madcatse/delta75-48kto128kupgrade/128k_expander_2/Delta_CA_addon_128K_v1.1.JPG

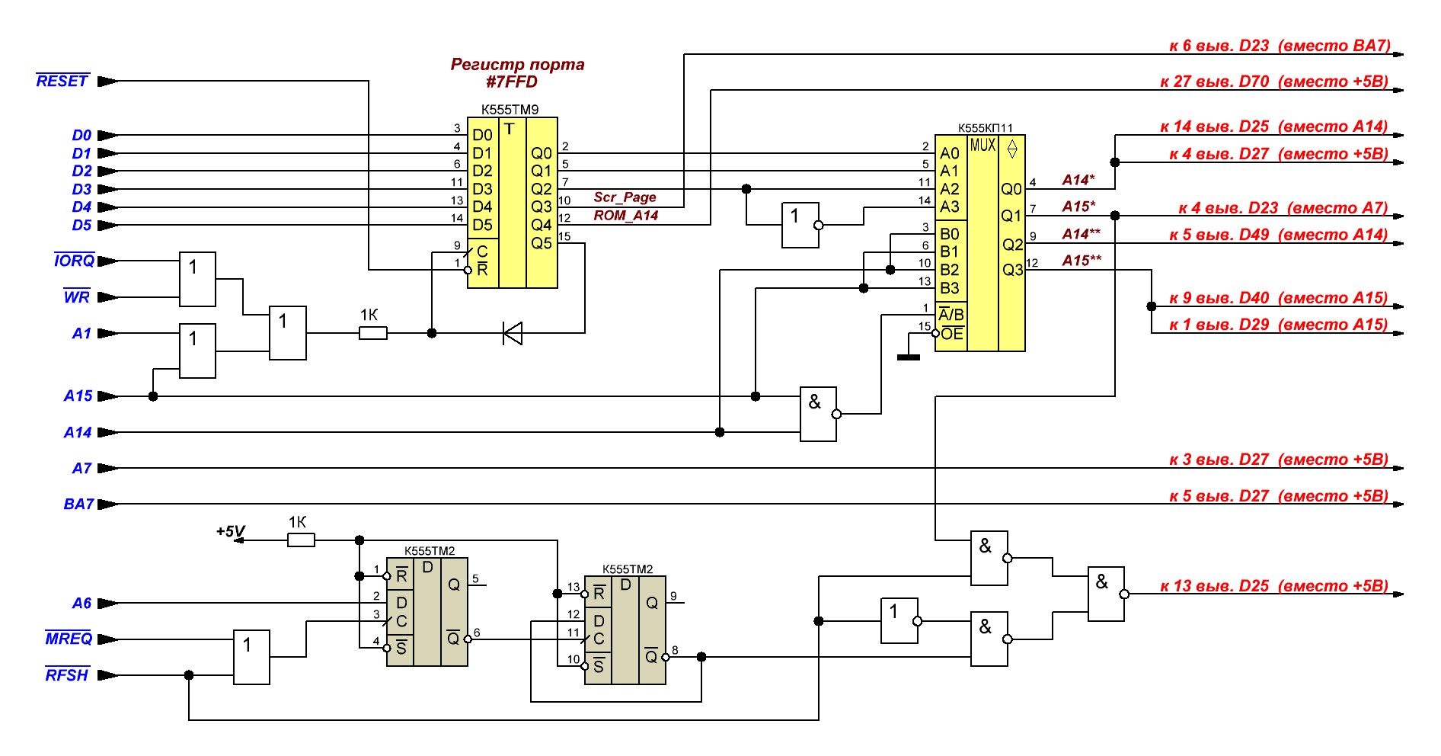
128k_expander_2/Delta_CA_addon_128K_v1.1.JPG
