madcatse/delta75-48kto128kupgrade/nedoPC/docs/00_Доработки Дельты_Лист 1.jpg

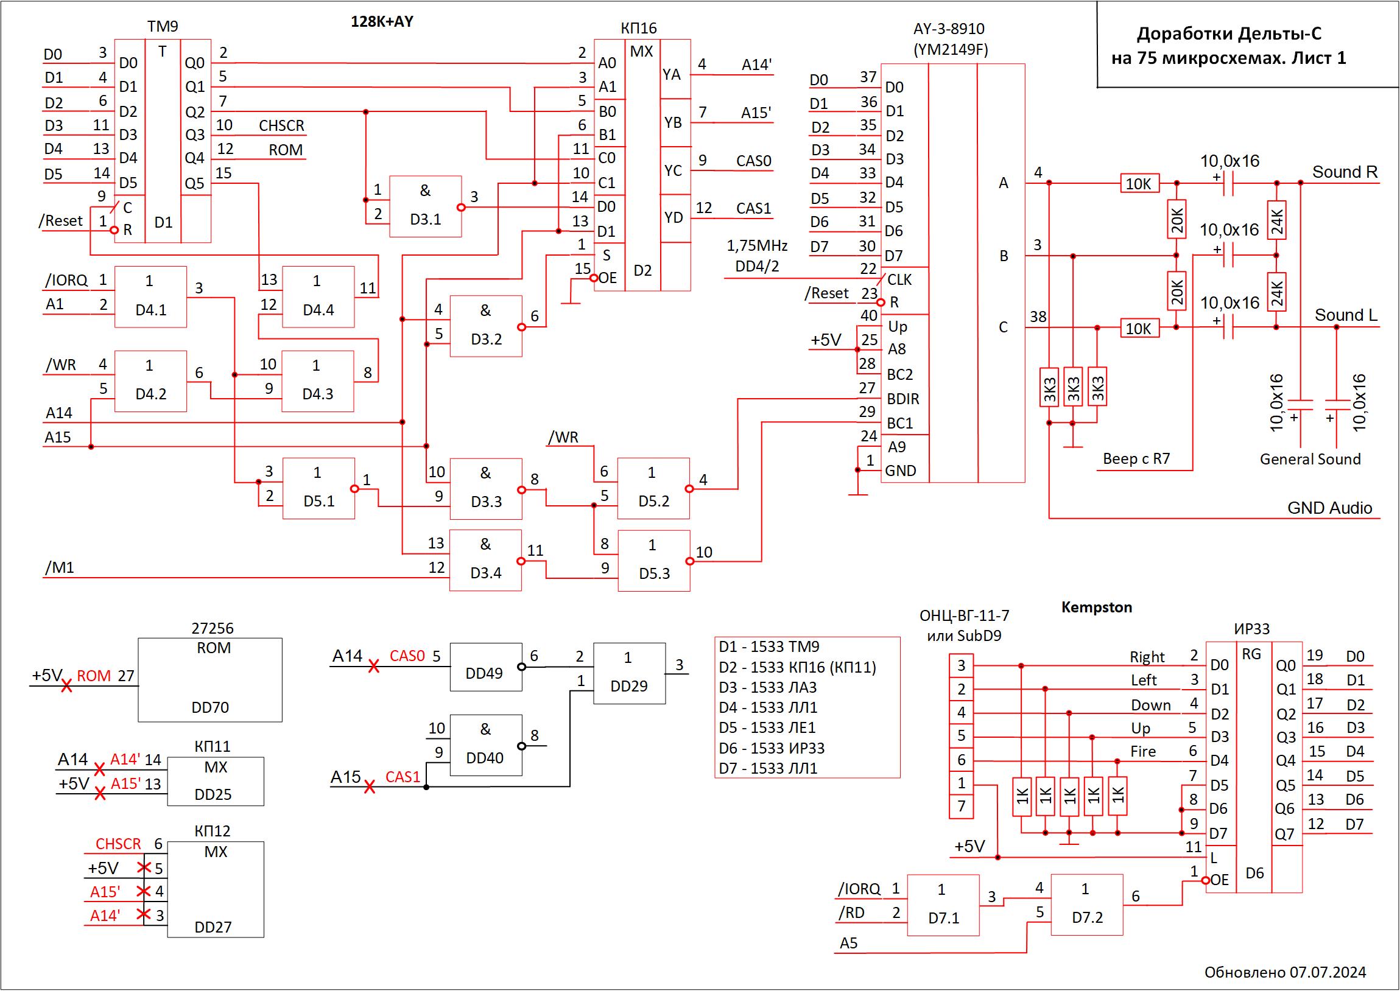
nedoPC/docs/00_Доработки Дельты_Лист 1.jpg
