madcatse/delta75-48kto128kupgrade/128k_expander_2/expander2.pdf

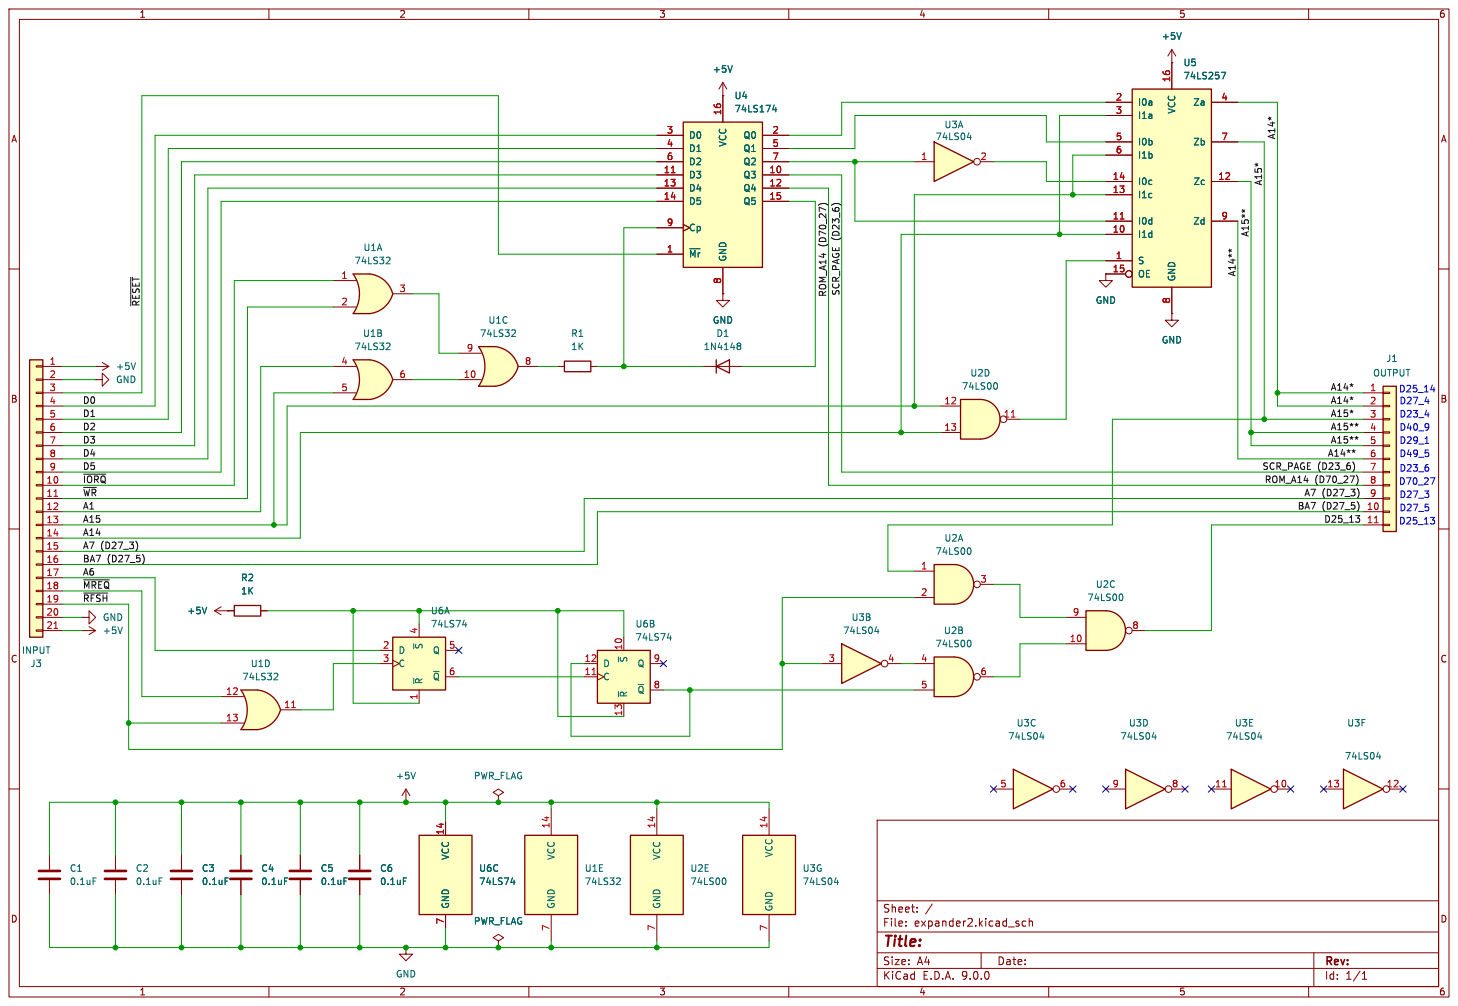
[picture p6: page 1]

8 Za 4 Zb 7 Zc 12 Zd 9 +5V GND GND

0.1uF GND
Id: 1/1 Title: File: expander2.kicad_sch Sheet: / +5V
