madcatse/delta75-48kto128kupgrade/new board/Схема 48_to_128-1.pdf

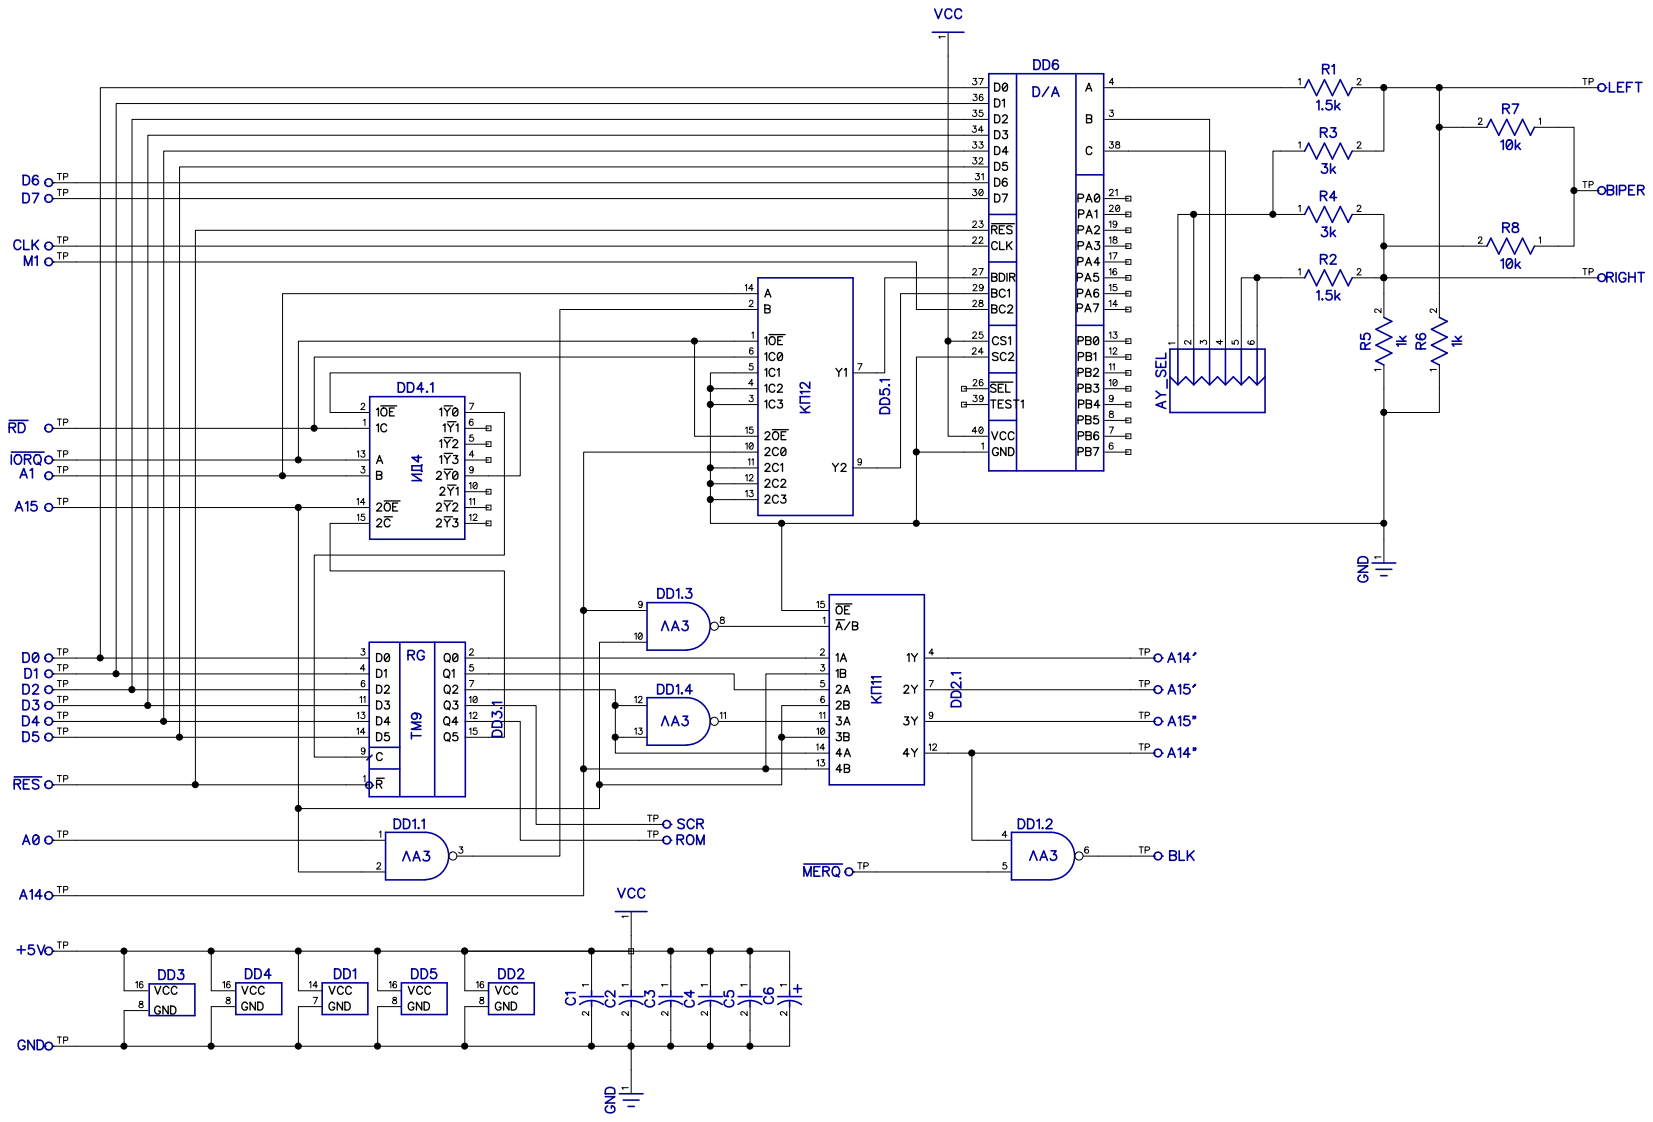
[picture p7: page 1]
