madcatse/delta75-48kto128kupgrade/128k_expander_2/expander2.kicad_pcb

## KiCad design 128k_expander_2/expander2.kicad_pcb (2025-03-25)

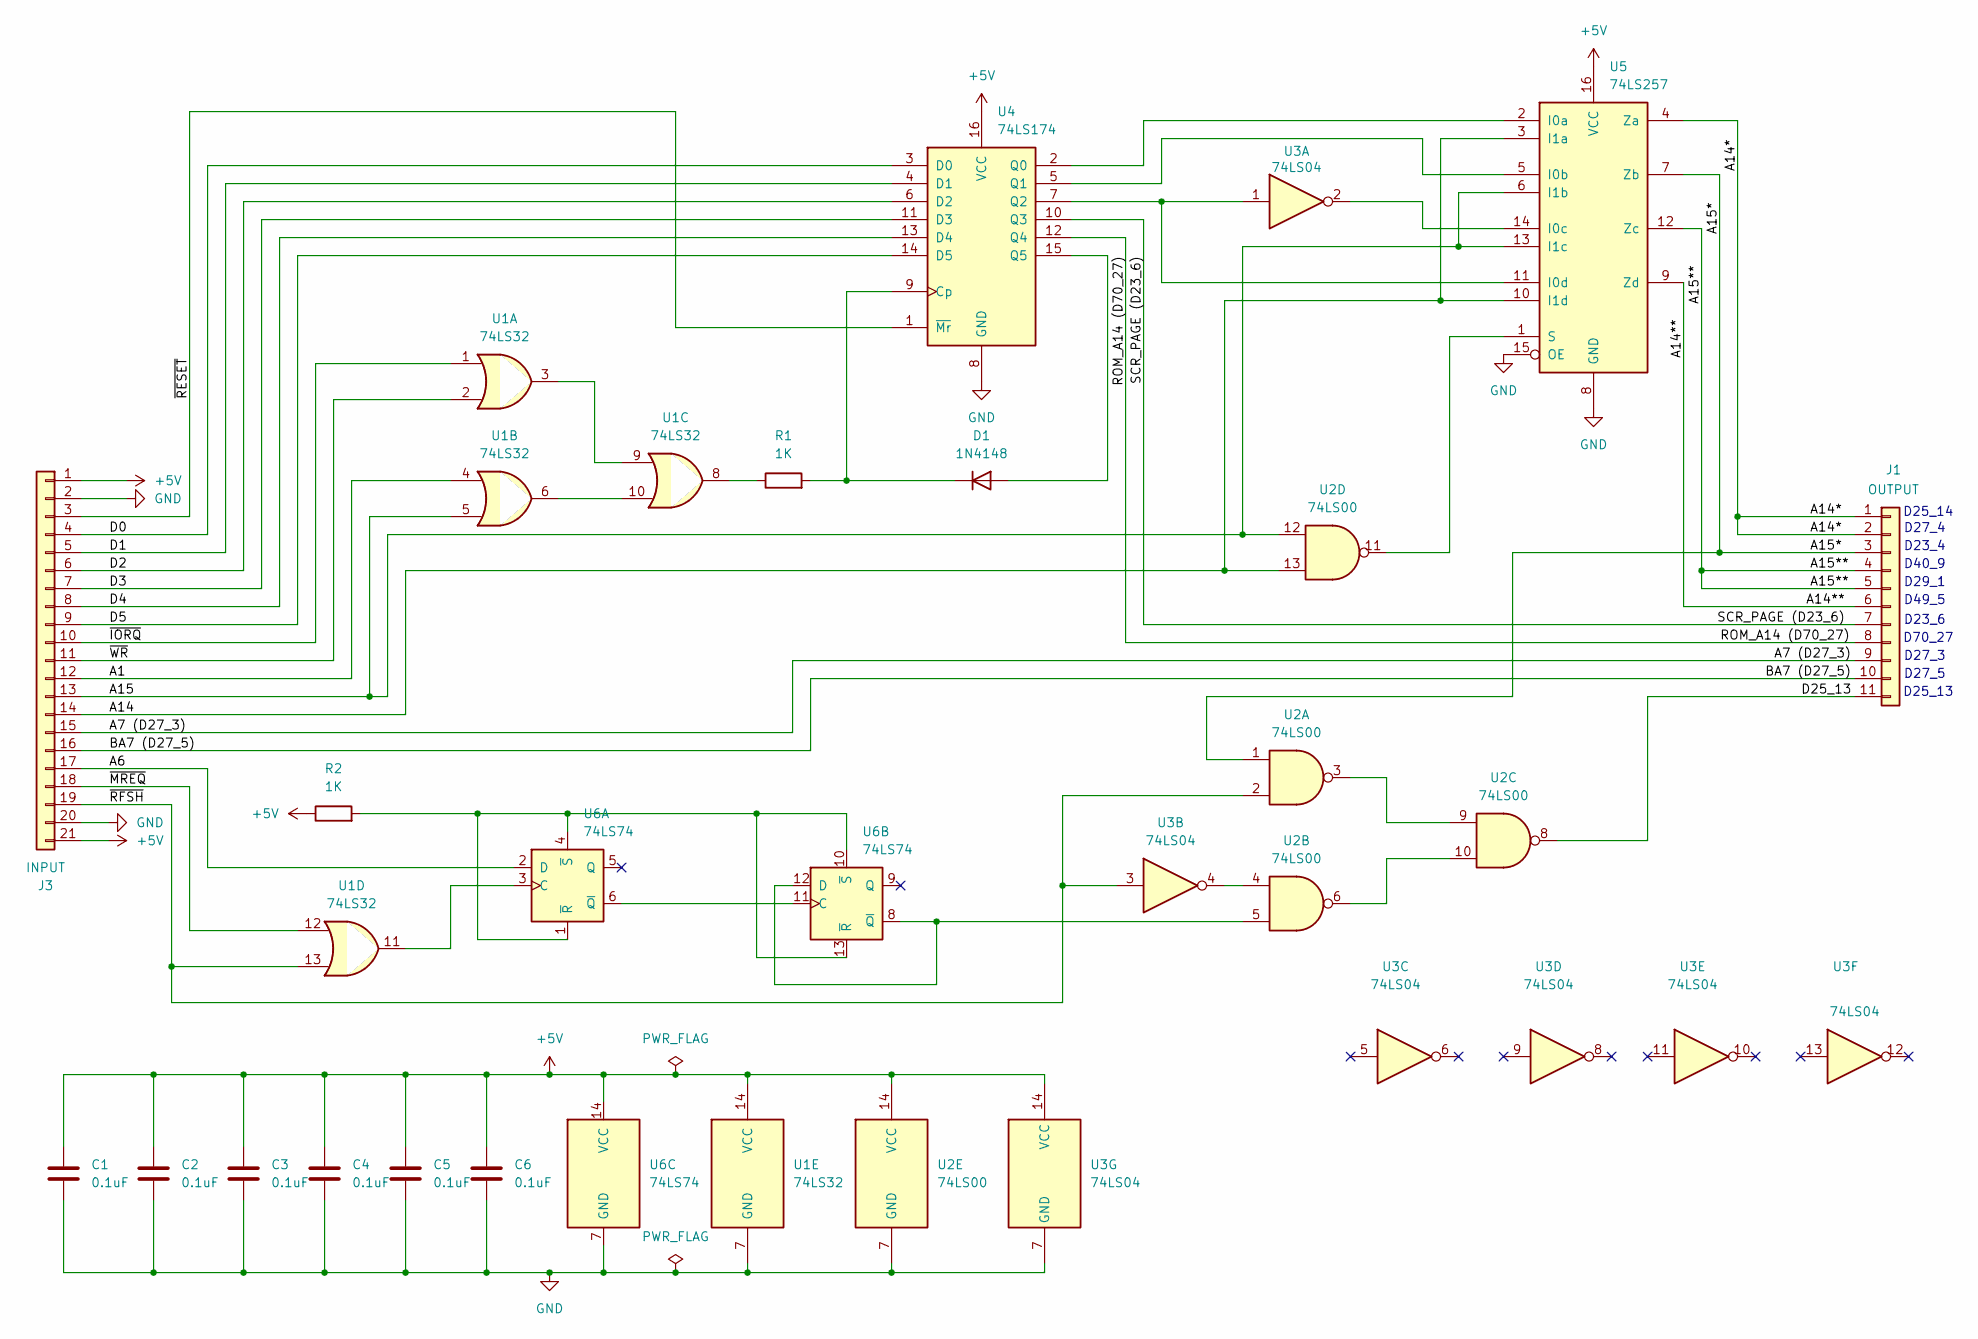
[picture p8: schematic expander2.kicad_sch]

Parts:
C1, C2, C3, C4, C5, C6: 0.1uF; C_Disc_D7.5mm_W2.5mm_P5.00mm
D1: 1N4148; D_DO-35_SOD27_P10.16mm_Horizontal
J1: OUTPUT; PinHeader_1x11_P2.54mm_Vertical
J3: INPUT; PinHeader_1x21_P2.54mm_Vertical
R1, R2: 1K; R_Axial_DIN0207_L6.3mm_D2.5mm_P10.16mm_Horizontal
U1: 74LS32; DIP-14_W7.62mm_Socket_LongPads
U2: 74LS00; DIP-14_W7.62mm_Socket_LongPads
U3: 74LS04; DIP-14_W7.62mm_Socket_LongPads
U4: 74LS174; DIP-16_W7.62mm_Socket_LongPads
U5: 74LS257; DIP-16_W7.62mm_Socket_LongPads
U6: 74LS74; DIP-14_W7.62mm_Socket_LongPads

Connections:
+5V: C1.1, C2.1, C3.1, C4.1, C5.1, C6.1, J3.1, J3.21, R2.1, U1.14 (VCC), U2.14 (VCC), U3.14 (VCC), U4.16 (VCC), U5.16 (VCC), U6.14 (VCC)
/A1: J3.12, U1.4
/A6: J3.17, U6.2 (D)
/A7 (D27_3): J1.9, J3.15
/A14: J3.14, U2.13, U5.3 (I1a), U5.10 (I1d)
/A14*: J1.1, J1.2, U5.4 (Za)
/A14**: J1.6, U5.9 (Zd)
/A15: J3.13, U1.5, U2.12, U5.6 (I1b), U5.13 (I1c)
/A15*: J1.3, U2.1, U5.7 (Zb)
/A15**: J1.4, J1.5, U5.12 (Zc)
/BA7 (D27_5): J1.10, J3.16
/D0: J3.4, U4.3 (D0)
/D1: J3.5, U4.4 (D1)
/D2: J3.6, U4.6 (D2)
/D3: J3.7, U4.11 (D3)
/D4: J3.8, U4.13 (D4)
/D5: J3.9, U4.14 (D5)
/D25_13: J1.11, U2.8
/ROM_A14 (D70_27): J1.8, U4.12 (Q4)
/SCR_PAGE (D23_6): J1.7, U4.10 (Q3)
/~IORQ: J3.10, U1.1
/~MREQ: J3.18, U1.12
/~RESET: J3.3, U4.1 (~Mr)
/~RFSH: J3.19, U1.13, U2.2, U3.3
/~WR: J3.11, U1.2
GND: C1.2, C2.2, C3.2, C4.2, C5.2, C6.2, J3.2, J3.20, U1.7 (GND), U2.7 (GND), U3.7 (GND), U4.8 (GND), U5.8 (GND), U5.15 (OE), U6.7 (GND)
unnamed: D1.2 (A), U4.15 (Q5)
unnamed: D1.1 (K), R1.2, U4.9 (Cp)
unnamed: R1.1, U1.8
unnamed: U1.3, U1.9
unnamed: U1.6, U1.10
unnamed: U2.3, U2.9
unnamed: U2.4, U3.4
unnamed: U2.6, U2.10
unnamed: U4.2 (Q0), U5.2 (I0a)
unnamed: U4.5 (Q1), U5.5 (I0b)
unnamed: U3.1, U4.7 (Q2), U5.11 (I0d)
unnamed: U3.2, U5.14 (I0c)
unnamed: U2.11, U5.1 (S)
unnamed: U1.11, U6.3 (C)
unnamed: U6.6 (~Q), U6.11 (C)
unnamed: R2.2, U6.1 (~R), U6.4 (~S), U6.10 (~S), U6.13 (~R)
unnamed: U2.5, U6.8 (~Q), U6.12 (D)

Notes on the sheet:
D70_27
D25_14
D40_9
D27_3
D29_1
D27_4
D49_5
D23_4
D25_13
D23_6
D27_5

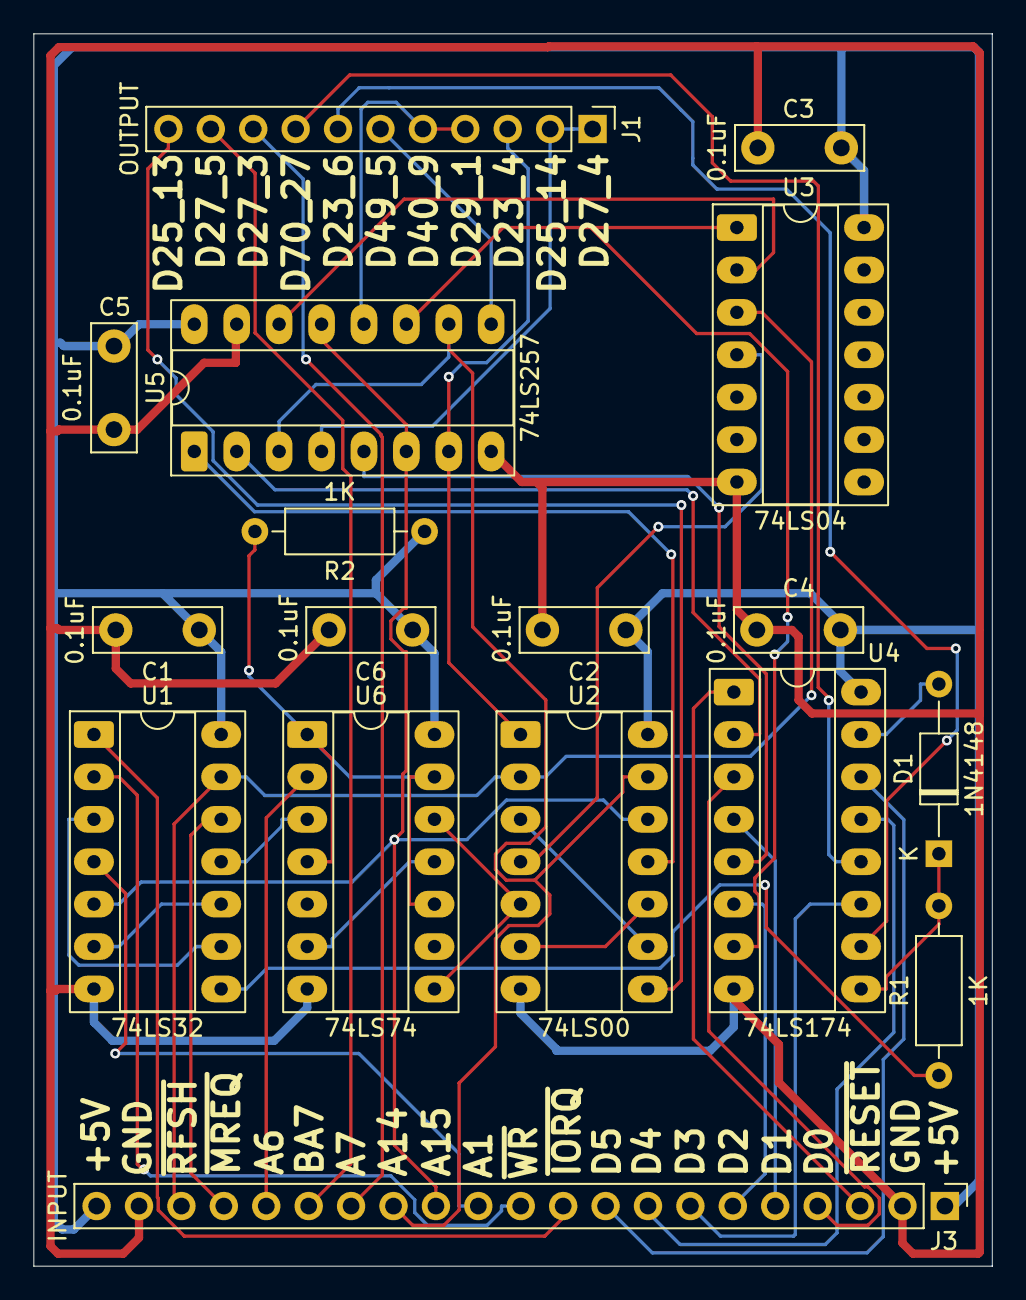
[picture p9: board expander2.kicad_pcb from above]

Board: 2 copper layers, 57.4 x 73.8 mm, 17 parts (0 on the bottom side), 43 nets.
