madcatse/delta75-48kto128kupgrade/128k_expander/128k_expander.kicad_pcb

## KiCad design 128k_expander/128k_expander.kicad_pcb (2025-03-24)

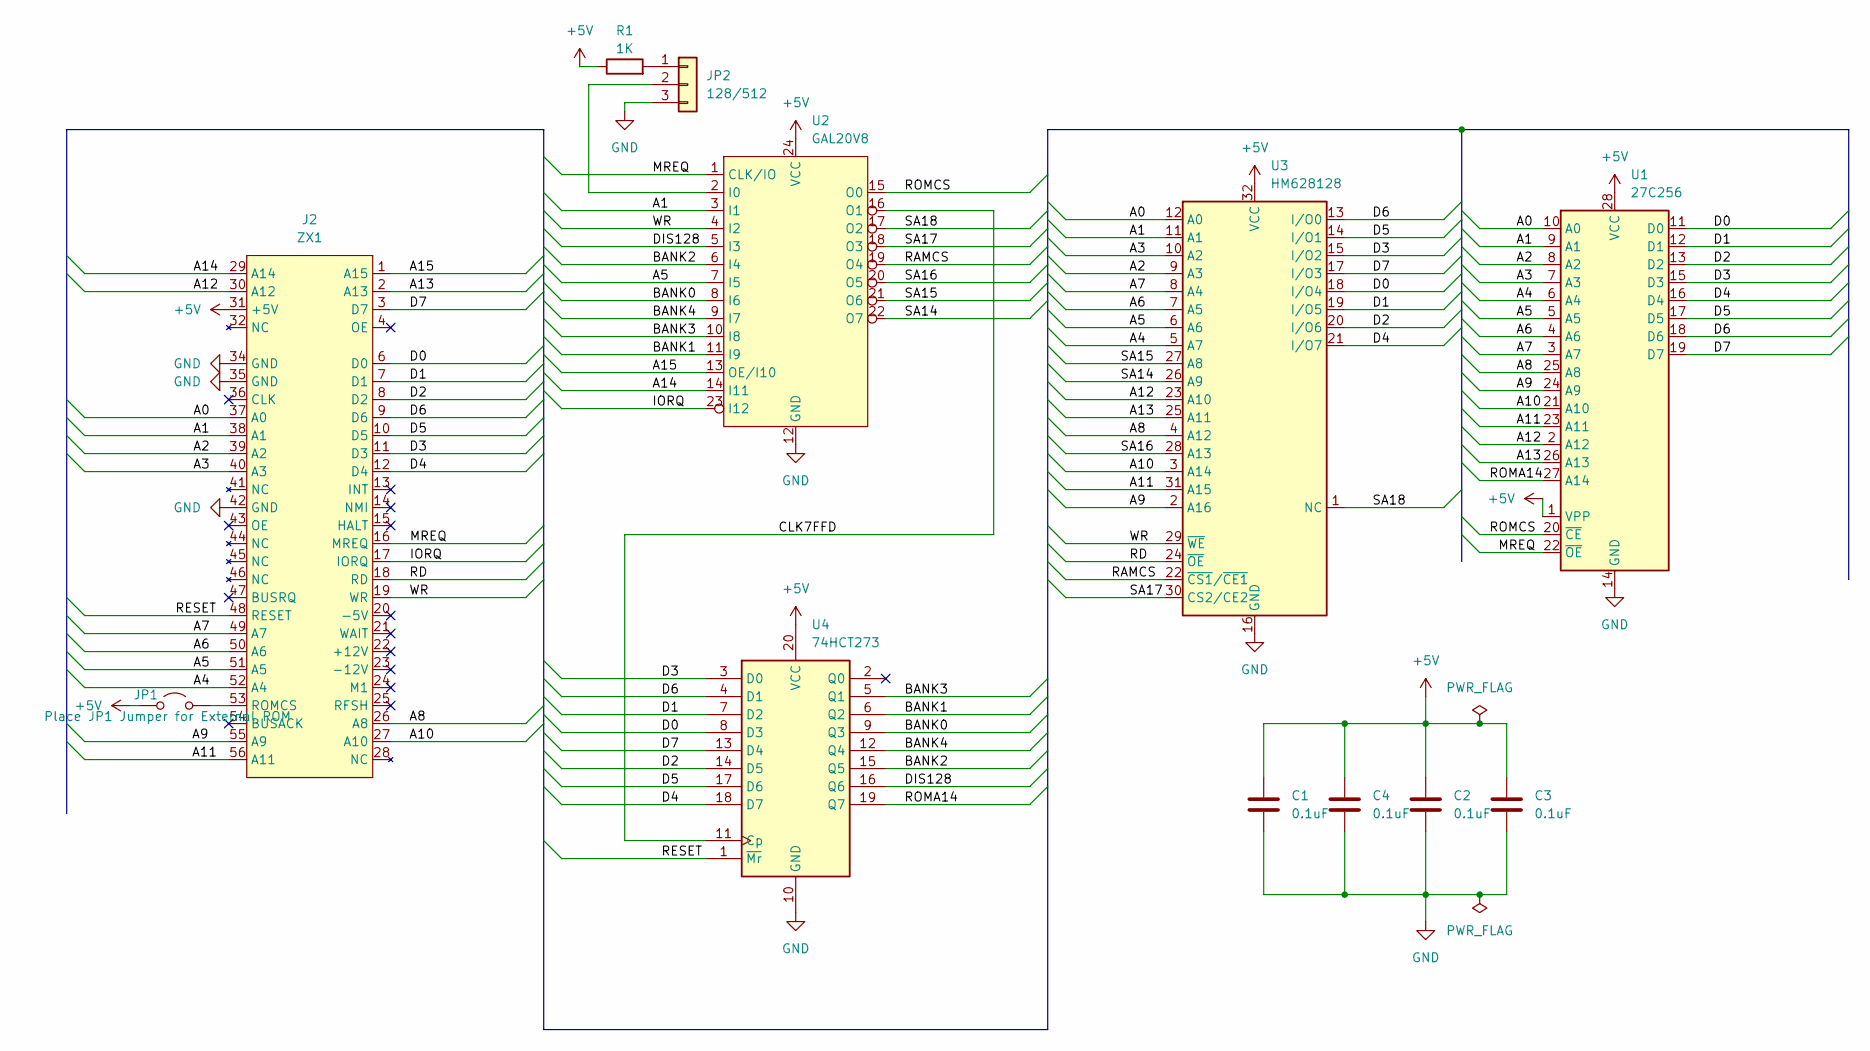
[picture p10: schematic 128k_expander.kicad_sch]

Parts:
C1, C2, C3, C4: 0.1uF; C_Disc_D7.5mm_W2.5mm_P5.00mm
J2: ZX1; ZX SPECTRUM EDGE CONNECTOR (HORIZONTAL)
JP1: Place JP1 Jumper for External ROM; PinHeader_1x02_P2.54mm_Vertical
JP2: 128/512; PinHeader_1x03_P2.54mm_Vertical
R1: 1K; R_Axial_DIN0207_L6.3mm_D2.5mm_P10.16mm_Horizontal
U1: 27C256; DIP-28_W15.24mm_LongPads
U2: GAL20V8; DIP-24_W7.62mm_LongPads
U3: HM628128; DIP-32_W15.24mm_LongPads
U4: 74HCT273; DIP-20_W7.62mm_LongPads

Connections:
+5V: C1.1, C2.1, C3.1, C4.1, J2.31 (+5V), JP1.1 (A), R1.1, U1.1 (VPP), U1.28 (VCC), U2.24 (VCC), U3.32 (VCC), U4.20 (VCC)
/A0: J2.37 (A0), U1.10 (A0), U3.12 (A0)
/A1: J2.38 (A1), U1.9 (A1), U2.3 (I1), U3.11 (A1)
/A2: J2.39 (A2), U1.8 (A2), U3.9 (A3)
/A3: J2.40 (A3), U1.7 (A3), U3.10 (A2)
/A4: J2.52 (A4), U1.6 (A4), U3.5 (A7)
/A5: J2.51 (A5), U1.5 (A5), U2.7 (I5), U3.6 (A6)
/A6: J2.50 (A6), U1.4 (A6), U3.7 (A5)
/A7: J2.49 (A7), U1.3 (A7), U3.8 (A4)
/A8: J2.26 (A8), U1.25 (A8), U3.4 (A12)
/A9: J2.55 (A9), U1.24 (A9), U3.2 (A16)
/A10: J2.27 (A10), U1.21 (A10), U3.3 (A14)
/A11: J2.56 (A11), U1.23 (A11), U3.31 (A15)
/A12: J2.30 (A12), U1.2 (A12), U3.23 (A10)
/A13: J2.2 (A13), U1.26 (A13), U3.25 (A11)
/A14: J2.29 (A14), U2.14 (I11)
/A15: J2.1 (A15), U2.13 (OE/I10)
/BANK0: U2.8 (I6), U4.9 (Q3)
/BANK1: U2.11 (I9), U4.6 (Q2)
/BANK2: U2.6 (I4), U4.15 (Q5)
/BANK3: U2.10 (I8), U4.5 (Q1)
/BANK4: U2.9 (I7), U4.12 (Q4)
/CLK7FFD: U2.16 (O1), U4.11 (Cp)
/D0: J2.6 (D0), U1.11 (D0), U3.18 (I/O4), U4.8 (D3)
/D1: J2.7 (D1), U1.12 (D1), U3.19 (I/O5), U4.7 (D2)
/D2: J2.8 (D2), U1.13 (D2), U3.20 (I/O6), U4.14 (D5)
/D3: J2.11 (D3), U1.15 (D3), U3.15 (I/O2), U4.3 (D0)
/D4: J2.12 (D4), U1.16 (D4), U3.21 (I/O7), U4.18 (D7)
/D5: J2.10 (D5), U1.17 (D5), U3.14 (I/O1), U4.17 (D6)
/D6: J2.9 (D6), U1.18 (D6), U3.13 (I/O0), U4.4 (D1)
/D7: J2.3 (D7), U1.19 (D7), U3.17 (I/O3), U4.13 (D4)
/DIS128: U2.5 (I3), U4.16 (Q6)
/IORQ: J2.17 (IORQ), U2.23 (I12)
/MREQ: J2.16 (MREQ), U1.22 (~OE), U2.1 (CLK/IO)
/RAMCS: U2.19 (O4), U3.22 (~CS1/~CE1)
/RD: J2.18 (RD), U3.24 (~OE)
/RESET: J2.48 (RESET), U4.1 (~Mr)
/ROMA14: U1.27 (A14), U4.19 (Q7)
/ROMCS: U1.20 (~CE), U2.15 (O0)
/SA14: U2.22 (O7), U3.26 (A9)
/SA15: U2.21 (O6), U3.27 (A8)
/SA16: U2.20 (O5), U3.28 (A13)
/SA17: U2.18 (O3), U3.30 (CS2/CE2)
/SA18: U2.17 (O2), U3.1 (NC)
/WR: J2.19 (WR), U2.4 (I2), U3.29 (~WE)
GND: C1.2, C2.2, C3.2, C4.2, J2.34 (GND), J2.35 (GND), J2.42 (GND), JP2.3, U1.14 (GND), U2.12 (GND), U3.16 (GND), U4.10 (GND)
unnamed: J2.53 (ROMCS), JP1.2 (B)
unnamed: JP2.1, R1.2
unnamed: JP2.2, U2.2 (I0)

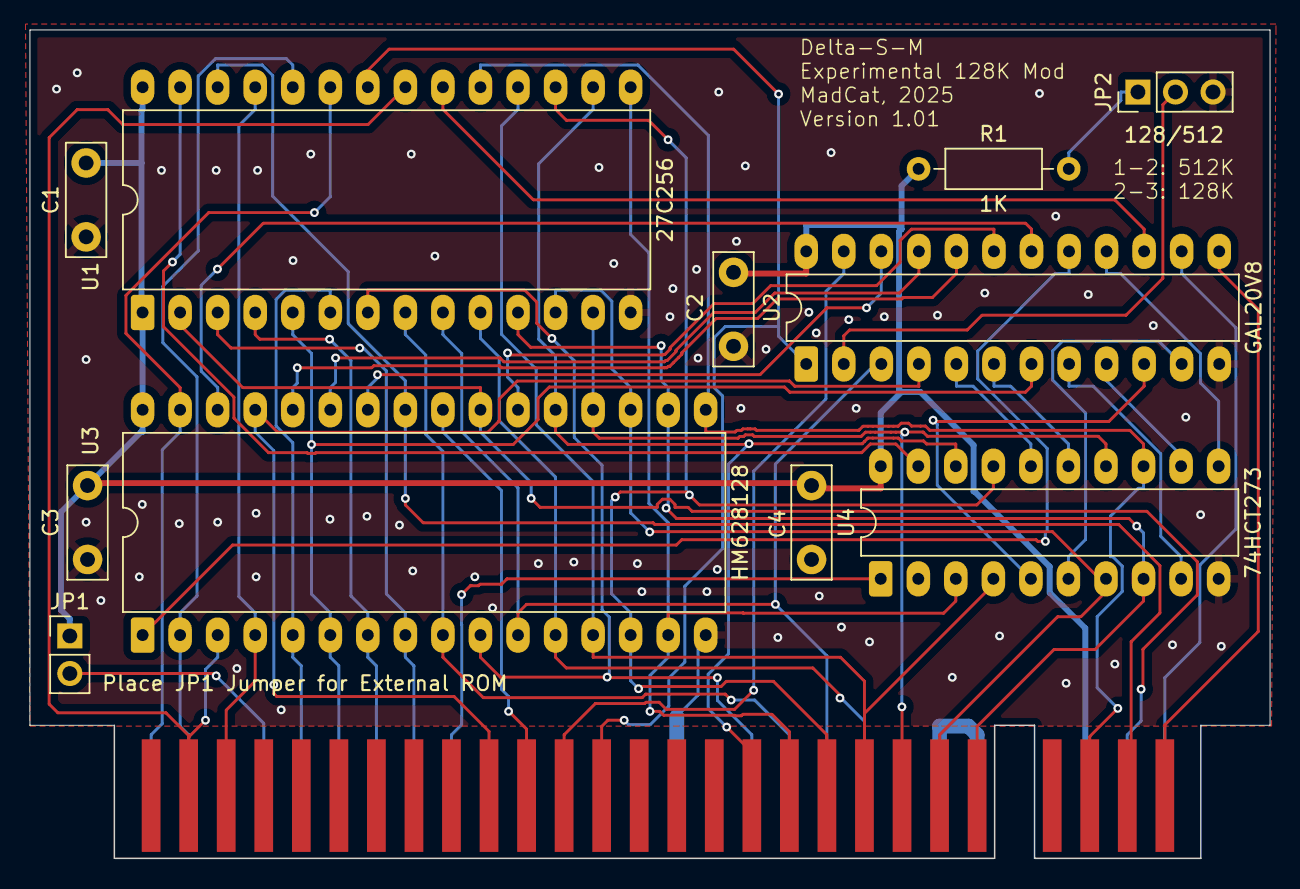
[picture p11: board 128k_expander.kicad_pcb from above]

Board: 2 copper layers, 83.9 x 56.0 mm, 12 parts (0 on the bottom side), 49 nets.
