madcatse/delta75-48kto128kupgrade/nedoPC/kicad/just_128.kicad_pcb

## KiCad design nedoPC/kicad/just_128.kicad_pcb (2024-12-30)

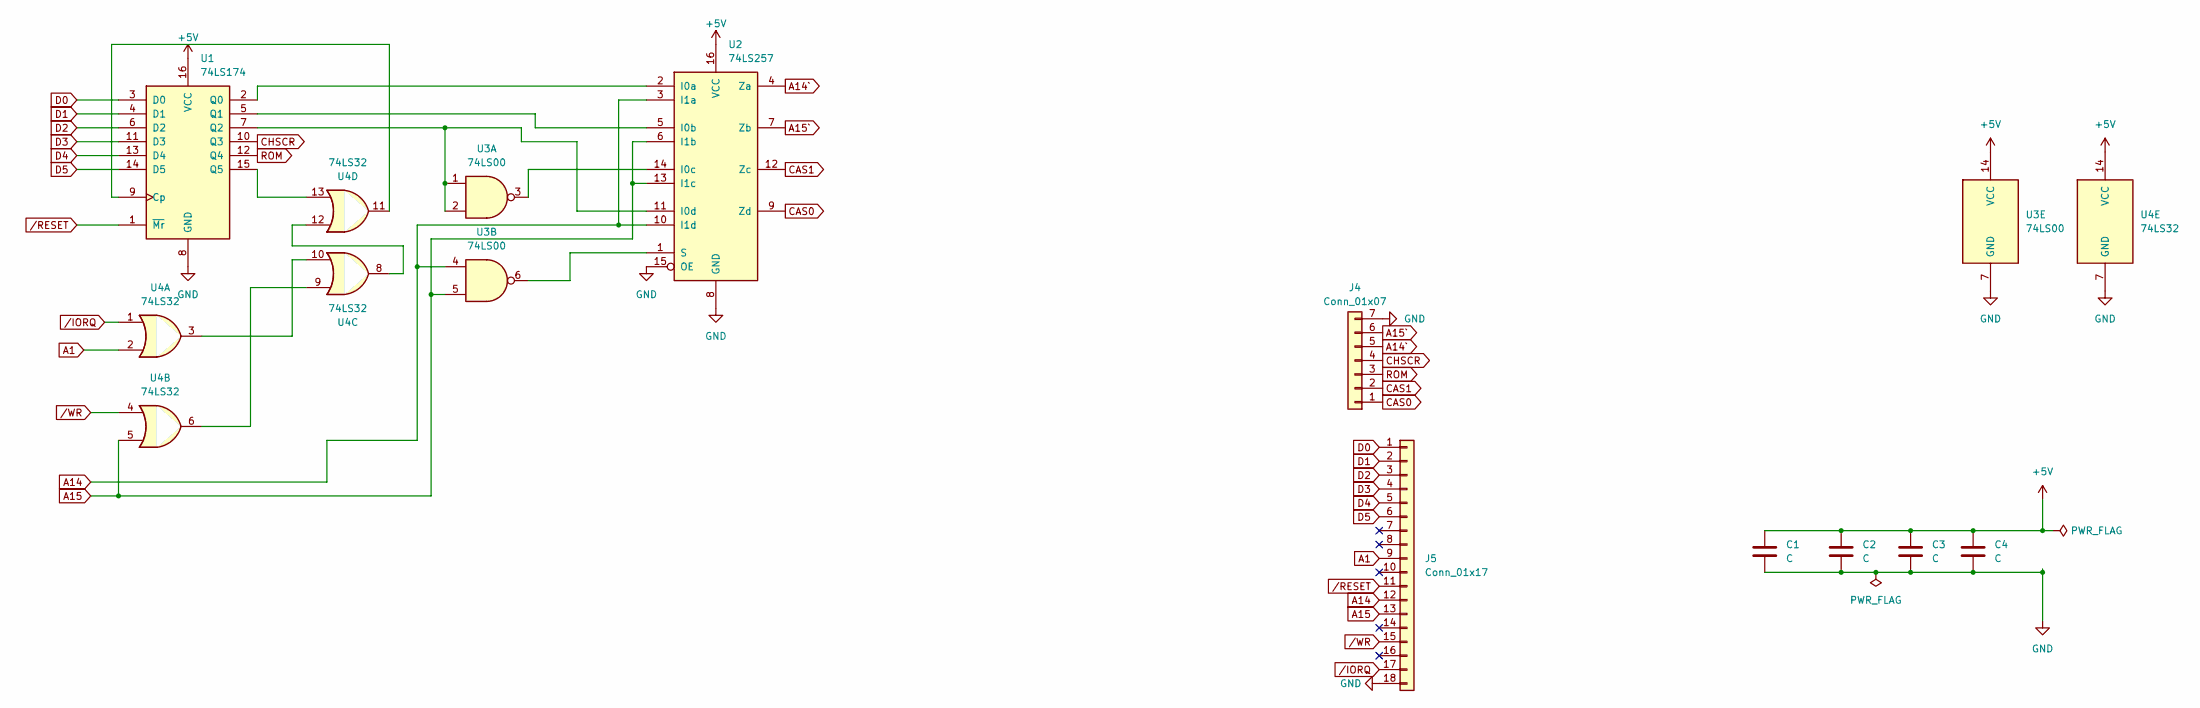
[picture p12: schematic just_128.kicad_sch]

Parts:
C1, C2, C3, C4: C; C_Disc_D7.0mm_W2.5mm_P5.00mm
J4: Conn_01x07; PinSocket_1x07_P2.54mm_Horizontal
J5: Conn_01x17; PinSocket_1x18_P2.54mm_Horizontal
U1: 74LS174; DIP-16_W7.62mm_Socket
U2: 74LS257; DIP-16_W7.62mm_Socket
U3: 74LS00; DIP-14_W7.62mm_Socket
U4: 74LS32; DIP-14_W7.62mm_Socket

Connections:
+5V: C1.1, C2.1, C3.1, C4.1, U1.16 (VCC), U2.16 (VCC), U3.14 (VCC), U4.14 (VCC)
A1: J5.9, U4.2
A14: J5.12, U2.3 (I1a), U2.10 (I1d), U3.4
A14`: J4.5, U2.4 (Za)
A15: J5.13, U2.6 (I1b), U2.13 (I1c), U3.5, U4.5
A15`: J4.6, U2.7 (Zb)
CAS0: J4.1, U2.9 (Zd)
CAS1: J4.2, U2.12 (Zc)
CHSCR: J4.4, U1.10 (Q3)
D0: J5.1, U1.3 (D0)
D1: J5.2, U1.4 (D1)
D2: J5.3, U1.6 (D2)
D3: J5.4, U1.11 (D3)
D4: J5.5, U1.13 (D4)
D5: J5.6, U1.14 (D5)
GND: C1.2, C2.2, C3.2, C4.2, J4.7, J5.18, U1.8 (GND), U2.8 (GND), U2.15 (OE), U3.7 (GND), U4.7 (GND)
unnamed: U1.9 (Cp), U4.11
unnamed: U1.2 (Q0), U2.2 (I0a)
unnamed: U1.5 (Q1), U2.5 (I0b)
unnamed: U1.7 (Q2), U2.11 (I0d), U3.1, U3.2
unnamed: U1.15 (Q5), U4.13
unnamed: U2.14 (I0c), U3.3
unnamed: U2.1 (S), U3.6
unnamed: U4.6, U4.9
unnamed: U4.3, U4.10
unnamed: U4.8, U4.12
ROM: J4.3, U1.12 (Q4)
/IORQ: J5.17, U4.1
/RESET: J5.11, U1.1 (~Mr)
/WR: J5.15, U4.4

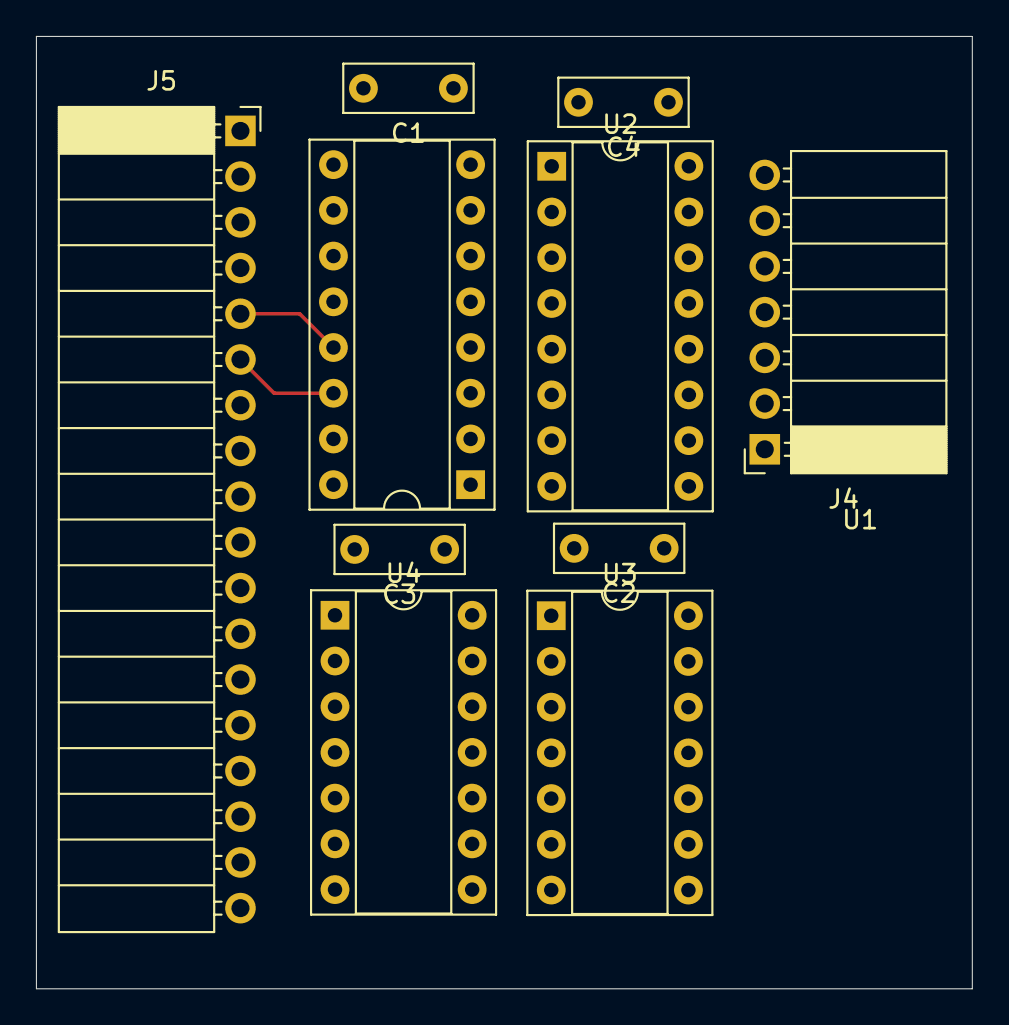
[picture p13: board just_128.kicad_pcb from above]

Board: 2 copper layers, 52.0 x 52.9 mm, 10 parts (0 on the bottom side), 30 nets.
