madcatse/delta75-48kto128kupgrade/nedoPC/kicad/nedoboard.kicad_pcb

## KiCad design nedoPC/kicad/nedoboard.kicad_pcb (2024-12-30)

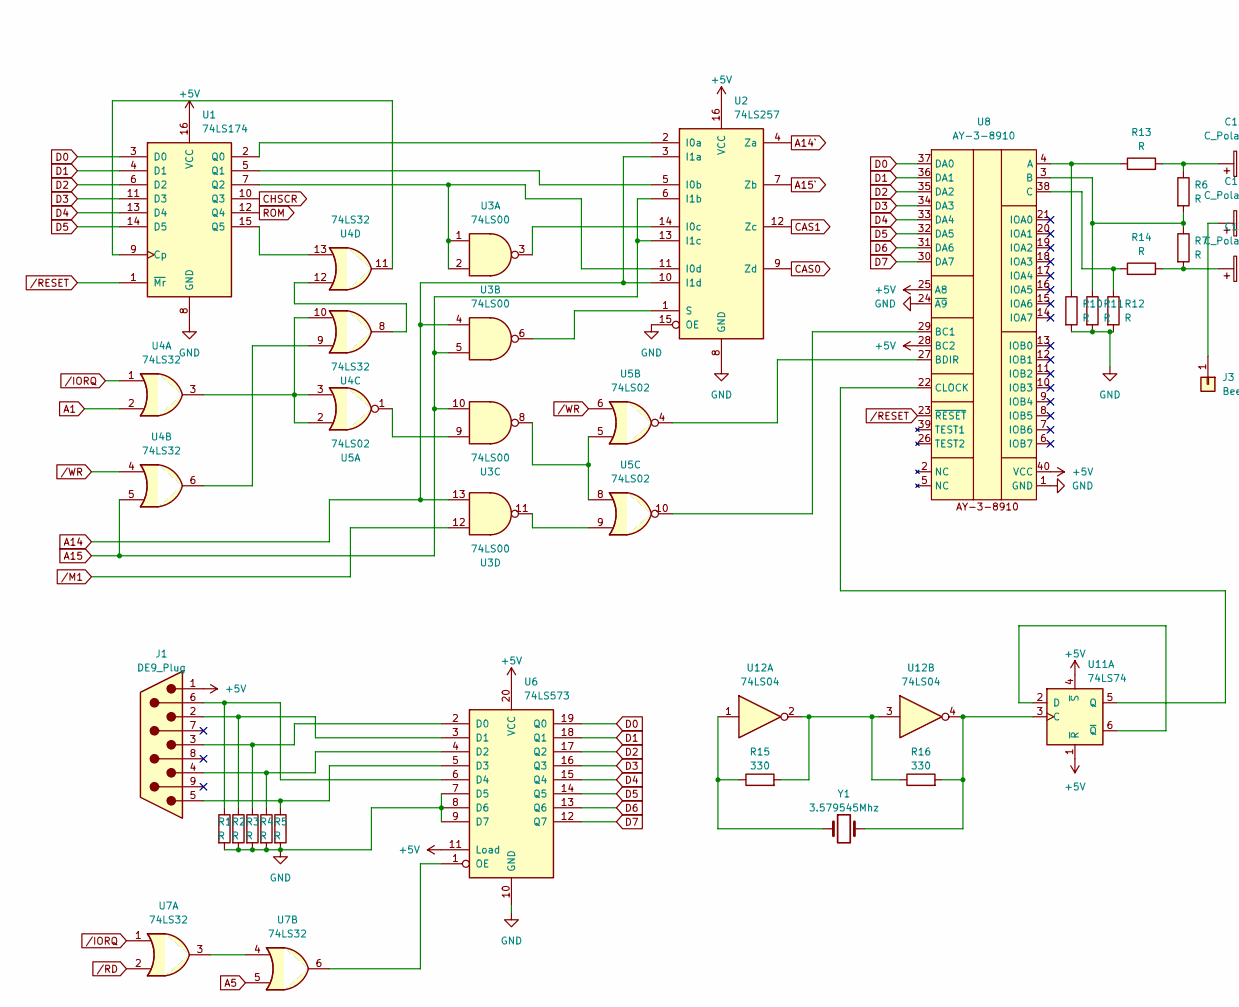
[picture p14: schematic nedoboard.kicad_sch, part in row 1, column 1]

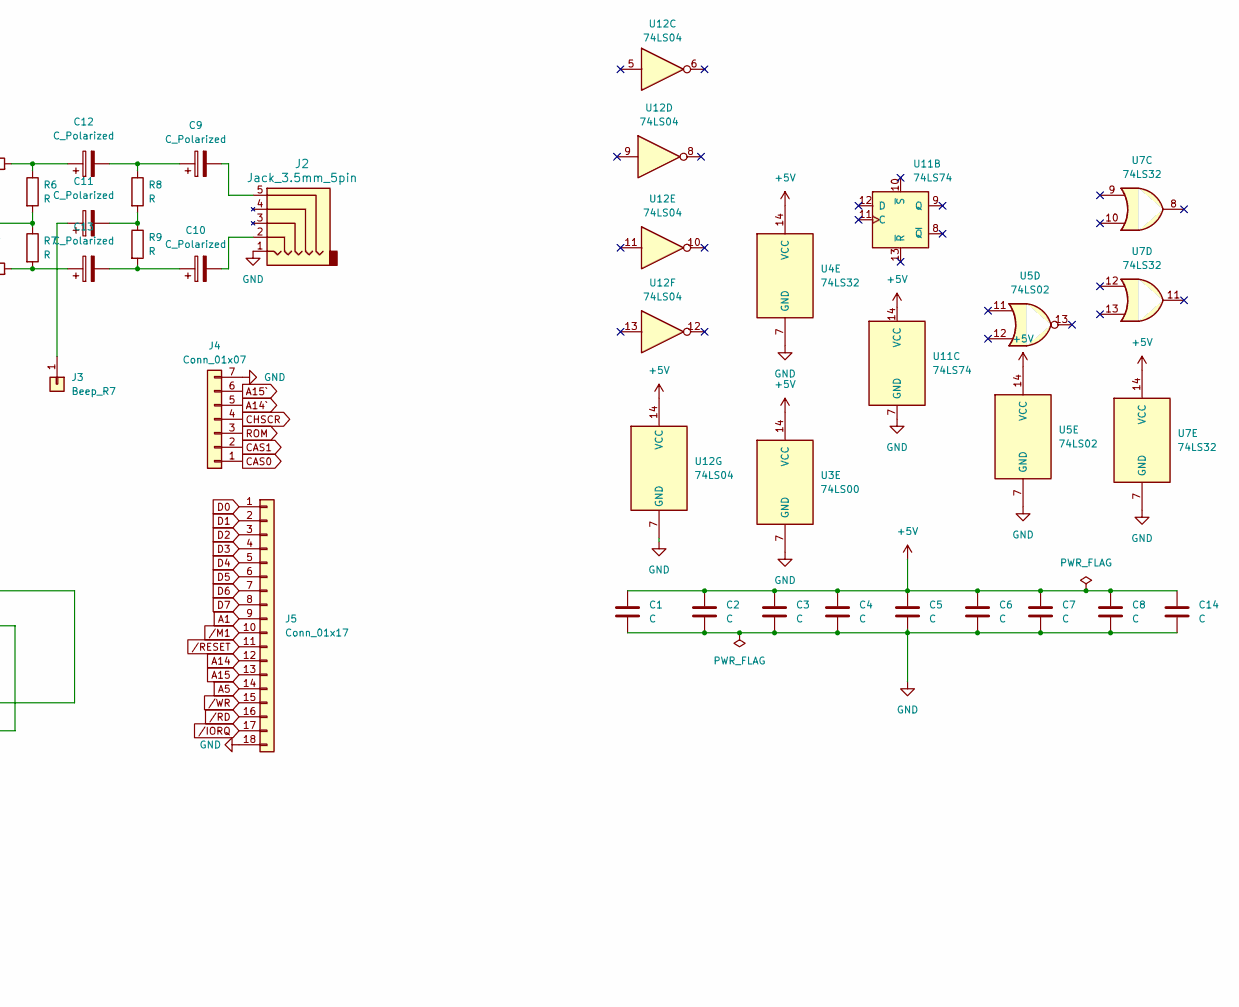
[picture p15: schematic nedoboard.kicad_sch, part in row 1, column 2]

Parts:
C1, C2, C3, C4, C5, C6, C7, C8, C14: C; C_Disc_D7.0mm_W2.5mm_P5.00mm
C9, C10, C11, C12, C13: C_Polarized; CP_Radial_D8.0mm_P3.80mm
J1: DE9_Plug; DSUB-9_Male_Horizontal_P2.77x2.84mm_EdgePinOffset4.94mm_Hou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
J2: Jack_3.5mm_5pin; jack_5_pin_3f07_FINAL
J3: Beep_R7; SolderWire-0.75sqmm_1x01_D1.25mm_OD3.5mm
J4: Conn_01x07; PinSocket_1x07_P2.54mm_Horizontal
J5: Conn_01x17; PinSocket_1x18_P2.54mm_Horizontal
R1, R2, R3, R4, R5, R6, R7, R8, R9, R10, R11, R12, R13, R14: R; R_Axial_DIN0207_L6.3mm_D2.5mm_P7.62mm_Horizontal
R15, R16: 330; R_Axial_DIN0207_L6.3mm_D2.5mm_P7.62mm_Horizontal
U1: 74LS174; DIP-16_W7.62mm_Socket
U2: 74LS257; DIP-16_W7.62mm_Socket
U3: 74LS00; DIP-14_W7.62mm_Socket
U4, U7: 74LS32; DIP-14_W7.62mm_Socket
U5: 74LS02; DIP-14_W7.62mm_Socket
U6: 74LS573; DIP-20_W7.62mm_Socket
U8: AY-3-8910; DIP-40_W15.24mm_Socket
U11: 74LS74; DIP-14_W7.62mm_Socket
U12: 74LS04; DIP-14_W7.62mm_Socket
Y1: 3.579545Mhz; Crystal_HC49-U_Horizontal

Connections:
+5V: C1.1, C2.1, C3.1, C4.1, C5.1, C6.1, C7.1, C8.1, C14.1, J1.1, U1.16 (VCC), U2.16 (VCC), U3.14 (VCC), U4.14 (VCC), U5.14 (VCC), U6.11 (Load), U6.20 (VCC), U7.14 (VCC), U8.25 (A8), U8.28 (BC2), U8.40 (VCC), U11.1 (~R), U11.4 (~S), U11.14 (VCC), U12.14 (VCC)
A1: J5.9, U4.2
A5: J5.14, U7.5
A14: J5.12, U2.3 (I1a), U2.10 (I1d), U3.4, U3.13
A14`: J4.5, U2.4 (Za)
A15: J5.13, U2.6 (I1b), U2.13 (I1c), U3.5, U3.10, U4.5
A15`: J4.6, U2.7 (Zb)
CAS0: J4.1, U2.9 (Zd)
CAS1: J4.2, U2.12 (Zc)
CHSCR: J4.4, U1.10 (Q3)
D0: J5.1, U1.3 (D0), U6.19 (Q0), U8.37 (DA0)
D1: J5.2, U1.4 (D1), U6.18 (Q1), U8.36 (DA1)
D2: J5.3, U1.6 (D2), U6.17 (Q2), U8.35 (DA2)
D3: J5.4, U1.11 (D3), U6.16 (Q3), U8.34 (DA3)
D4: J5.5, U1.13 (D4), U6.15 (Q4), U8.33 (DA4)
D5: J5.6, U1.14 (D5), U6.14 (Q5), U8.32 (DA5)
D6: J5.7, U6.13 (Q6), U8.31 (DA6)
D7: J5.8, U6.12 (Q7), U8.30 (DA7)
GND: C1.2, C2.2, C3.2, C4.2, C5.2, C6.2, C7.2, C8.2, C14.2, J2.1, J4.7, J5.18, R1.2, R2.2, R3.2, R4.2, R5.2, R10.2, R11.2, R12.2, U1.8 (GND), U2.8 (GND), U2.15 (OE), U3.7 (GND), U4.7 (GND), U5.7 (GND), U6.7 (D5), U6.8 (D6), U6.9 (D7), U6.10 (GND), U7.7 (GND), U8.1 (GND), U8.24 (~A9), U11.7 (GND), U12.7 (GND)
unnamed: C9.2, J2.5
unnamed: C10.1, C13.2, R9.2
unnamed: C10.2, J2.2
unnamed: C11.2, R8.2, R9.1
unnamed: C12.1, R6.1, R13.2
unnamed: C9.1, C12.2, R8.1
unnamed: C13.1, R7.2, R14.2
unnamed: C11.1, J3.1
unnamed: R15.1, U12.1, Y1.1
unnamed: R15.2, R16.1, U12.2, U12.3
unnamed: U1.9 (Cp), U4.11
unnamed: U1.2 (Q0), U2.2 (I0a)
unnamed: U1.5 (Q1), U2.5 (I0b)
unnamed: U1.7 (Q2), U2.11 (I0d), U3.1, U3.2
unnamed: U1.15 (Q5), U4.13
unnamed: U2.14 (I0c), U3.3
unnamed: U2.1 (S), U3.6
unnamed: U3.8, U5.5, U5.8
unnamed: U3.9, U5.1
unnamed: U3.11, U5.9
unnamed: U4.6, U4.9
unnamed: U4.3, U4.10, U5.2, U5.3
unnamed: U4.8, U4.12
unnamed: J1.3, R3.1, U6.2 (D0)
unnamed: J1.2, R2.1, U6.3 (D1)
unnamed: J1.4, R4.1, U6.4 (D2)
unnamed: J1.5, R5.1, U6.5 (D3)
unnamed: J1.6, R1.1, U6.6 (D4)
unnamed: U6.1 (OE), U7.6
unnamed: U7.3, U7.4
unnamed: R10.1, R13.1, U8.4 (A)
unnamed: R6.2, R7.1, R11.1, U8.3 (B)
unnamed: U5.10, U8.29 (BC1)
unnamed: U5.4, U8.27 (BDIR)
unnamed: R12.1, R14.1, U8.38 (C)
unnamed: R16.2, U11.3 (C), U12.4, Y1.2
unnamed: U11.2 (D), U11.6 (~Q)
unnamed: U8.22 (CLOCK), U11.5 (Q)
ROM: J4.3, U1.12 (Q4)
/IORQ: J5.17, U4.1, U7.1
/M1: J5.10, U3.12
/RD: J5.16, U7.2
/RESET: J5.11, U1.1 (~Mr), U8.23 (~RESET)
/WR: J5.15, U4.4, U5.6

Board: 2 copper layers, 46 parts (0 on the bottom side), 63 nets, no tracks yet.
