madcatse/delta75-48kto128kupgrade/AY/KiCAD/ayinterface.kicad_sch

## KiCad design AY/KiCAD/ayinterface.kicad_sch (2023-09-17)

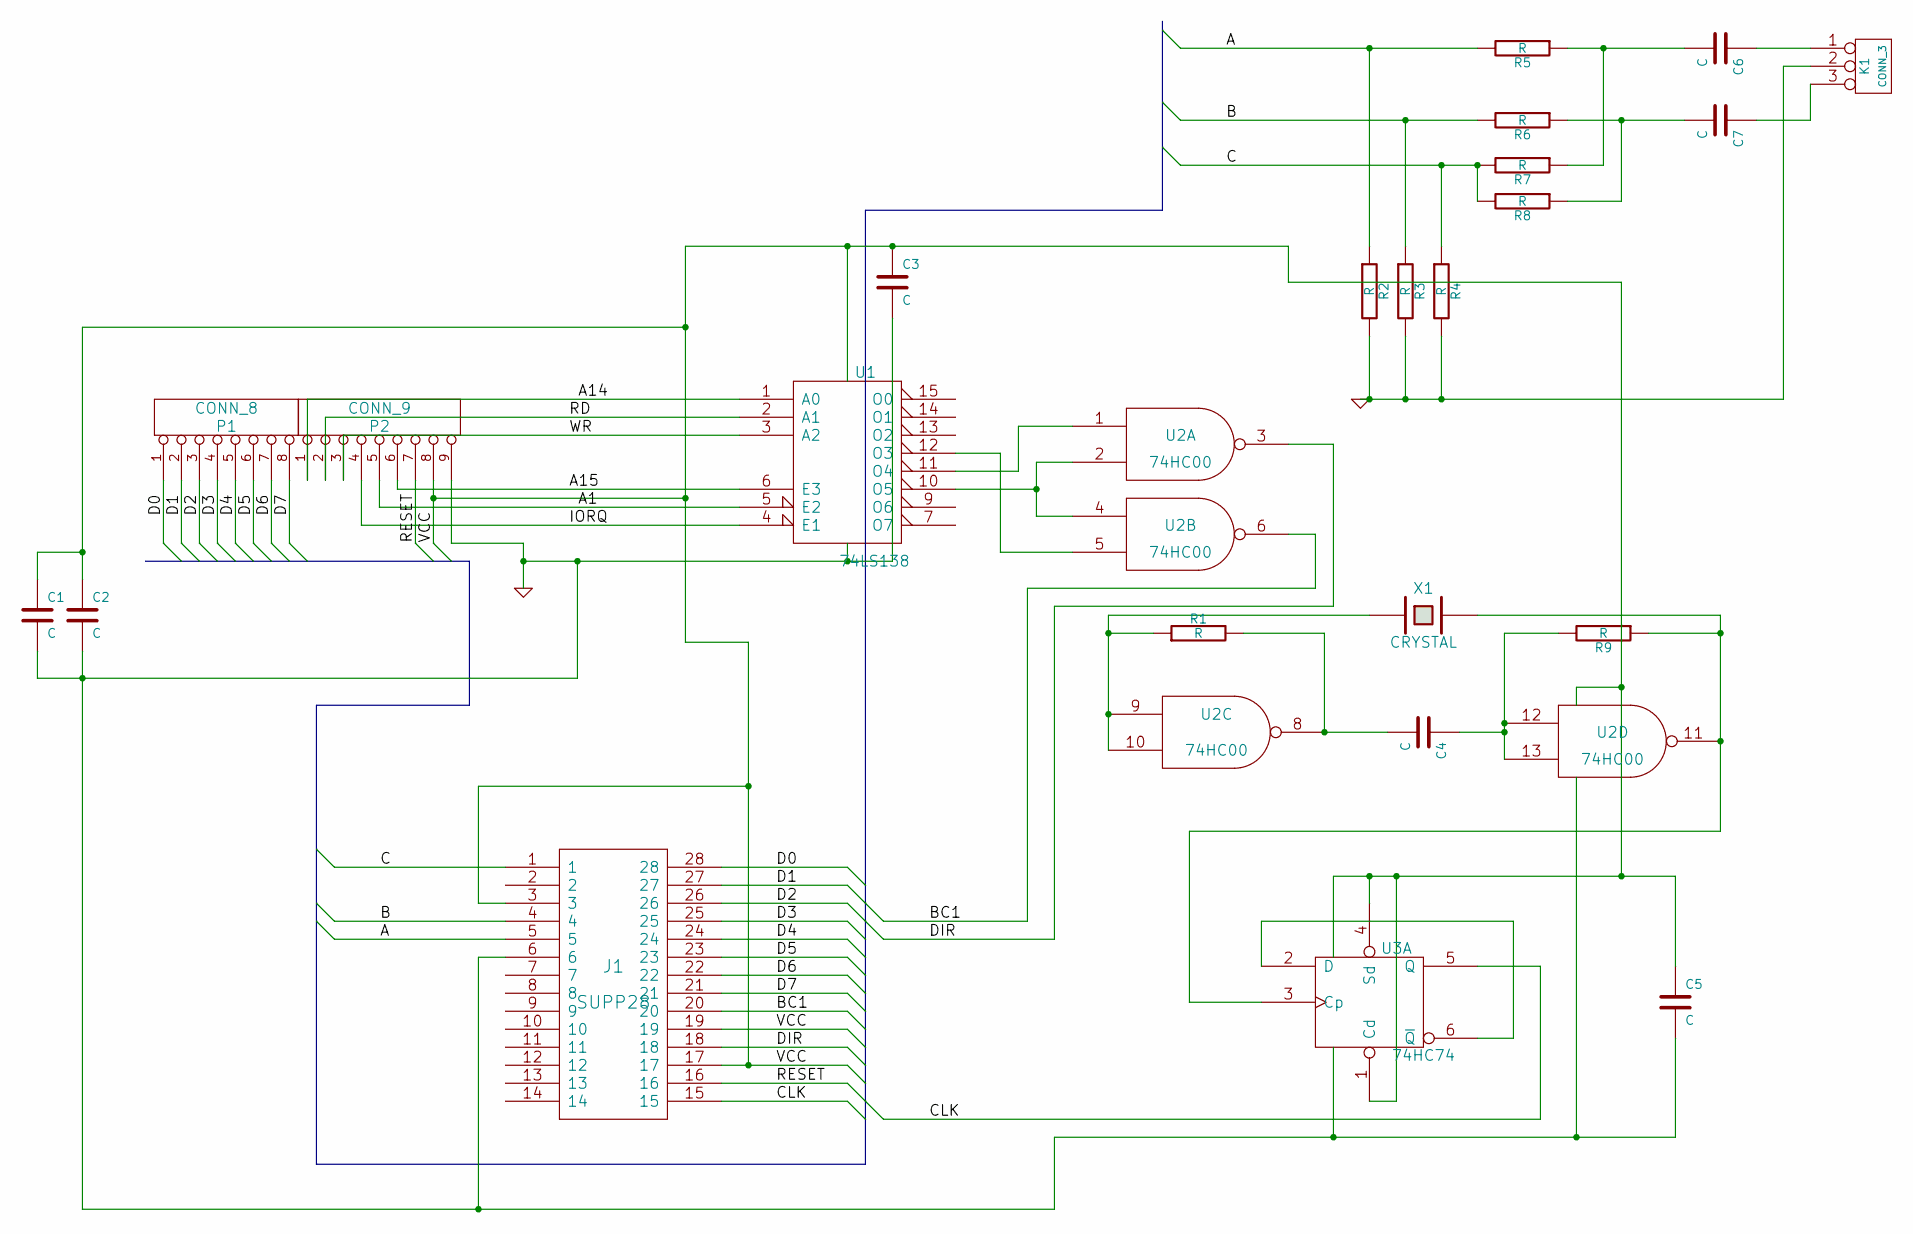
[picture p16: schematic ayinterface.kicad_sch]

Parts:
C1, C2, C3, C4, C5, C6, C7: C
J1: SUPP28
K1: CONN_3
P1: CONN_8
P2: CONN_9
R1, R2, R3, R4, R5, R6, R7, R8, R9: R
U1: 74LS138
U2: 74HC00
U3: 74HC74
X1: CRYSTAL

Connections:
A: J1.5, R2.1, R5.2
A1: P2.5, U1.5 (E2)
A14: P2.1, U1.1 (A0)
A15: P2.6, U1.6 (E3)
B: J1.4, R3.1, R6.2
BC1: J1.20, U2.6
C: J1.1, R4.1, R7.2, R8.2
CLK: J1.15, U3.5 (Q)
D0: J1.28, P1.1
D1: J1.27, P1.2
D2: J1.26, P1.3
D3: J1.25, P1.4
D4: J1.24, P1.5
D5: J1.23, P1.6
D6: J1.22, P1.7
D7: J1.21, P1.8
DIR: J1.18, U2.3
GND: C1.2, C2.2, C3.2, C5.2, J1.6, K1.2 (PM), P2.9, R2.2, R3.2, R4.2, U1.8 (GND), U2.7 (GND), U3.7 (GND)
IORQ: P2.4, U1.4 (E1)
unnamed: C4.1, R9.2, U2.12, U2.13
unnamed: C4.2, R1.2, U2.8
unnamed: C6.1, K1.1
unnamed: C6.2, R5.1, R7.1
unnamed: C7.1, K1.3
unnamed: C7.2, R6.1, R8.1
unnamed: R1.1, U2.9, U2.10, X1.1
unnamed: R9.1, U2.11, U3.3 (Cp), X1.2
unnamed: U1.10 (O5), U2.2, U2.4
unnamed: U1.11 (O4), U2.1
unnamed: U1.12 (O3), U2.5
unnamed: U3.2 (D), U3.6 (~Q)
RD: P2.2, U1.2 (A1)
RESET: J1.16, P2.7
VCC: C1.1, C2.1, C3.1, C5.1, J1.3, J1.17, J1.19, P2.8, U1.16 (VCC), U2.14 (VCC), U3.1 (Cd), U3.4 (Sd), U3.14 (VCC)
WR: P2.3, U1.3 (A2)
