madcatse/delta75-48kto128kupgrade/(commit log)

2024-05-31 New board
    [board.kicad_pcb, board.kicad_sch]
2024-12-20 NedoPC import
    [nedoboard.kicad_pcb, nedoboard.kicad_sch]
2024-12-20 Update nedopc
    [nedoboard.kicad_sch]
2025-03-24 128 Expander
    [128k_expander-B_Cu.gbr, 128k_expander-B_Mask.gbr, 128k_expander-B_Silkscreen.gbr, 128k_expander-Edge_Cuts.gbr, 128k_expander-F_Cu.gbr, 128k_expander-F_Mask.gbr, 128k_expander-F_Silkscreen.gbr, 128k_expander-NPTH.drl]
